HubertD/candleLight/export/v1.1/png/back.jpg

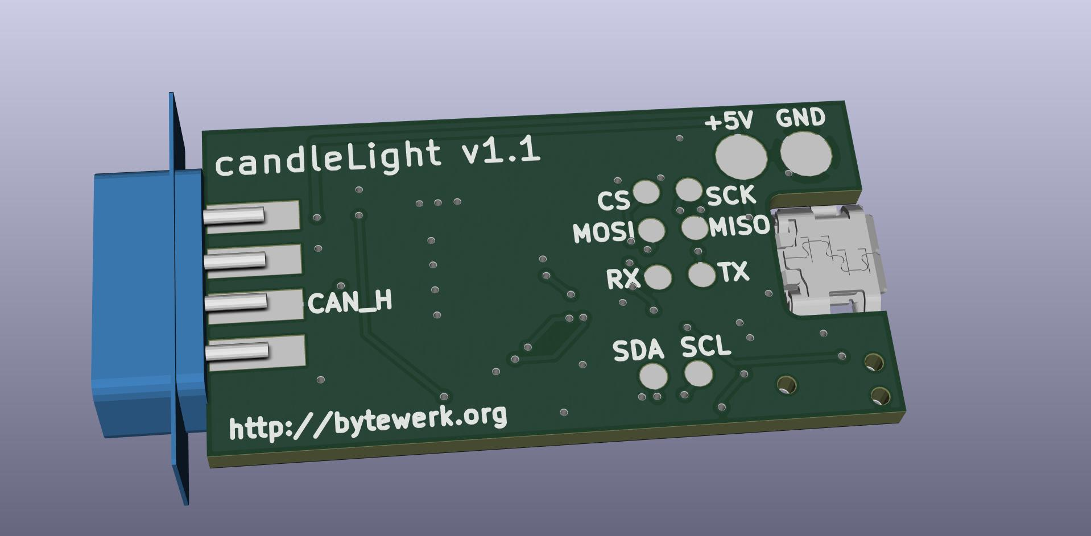
export/v1.1/png/back.jpg
