HubertD/candleLight/export/v1.1/png/front.jpg

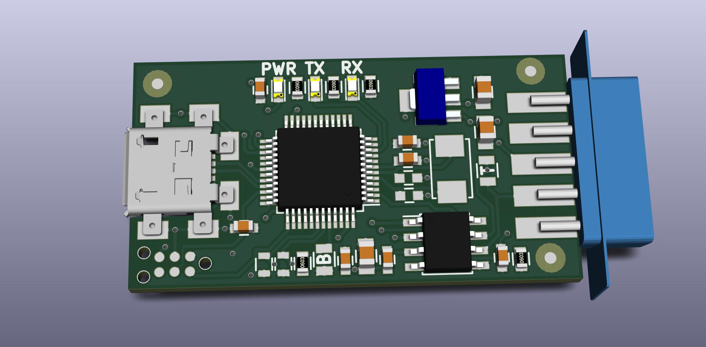
export/v1.1/png/front.jpg
