HubertD/candleLight/export/v1.1/bom/candleLight-v1.1.xls

Id | Designator | Package | Qty | Designation | Spec | Manufacturer | MPN | Link
1 | C207,C301,C303 | C_0805 | 3 | 10uF | MLCC/10uF/10V | Murata | GRM21BR71A106KA73L | http://www.mouser.de/Search/ProductDetail.aspx?R=GRM21BR71A106KA73L
2 | C206,C403,C203,C204,C205,C402,C208 | C_0603 | 7 | 100nF | MLCC/0.1uF/10V | AVX | 0603YC104KAT2A | http://www.mouser.de/Search/ProductDetail.aspx?R=0603YC104KAT2A
3 | R204,R601,R602,R603 | R_0603 | 4 | 1K | 1K/5% | Yageo | RC0603FR-071KL | http://www.mouser.de/Search/ProductDetail.aspx?R=RC0603FR-071KL
4 | R401 | R_0603 | 1 | 10K | 10K/5% | Yageo | RC0603FR-0710KL | http://www.mouser.de/Search/ProductDetail.aspx?R=RC0603FR-0710KL
5 | D601 | LED_0603 | 1 | LED | green,any | Kingbright | APT1608SGC | http://www.mouser.de/Search/ProductDetail.aspx?R=APT1608SGC
6 | D602 | LED_0603 | 1 | LED | yellow, any | Kingbright | APT1608YC | http://www.mouser.de/Search/ProductDetail.aspx?R=APT1608YC
7 | D603 | LED_0603 | 1 | LED | red, any | Kingbright | APT1608EC | http://www.mouser.de/Search/ProductDetail.aspx?R=APT1608EC
8 | U301 | SOT89-3 | 1 | MCP1754ST-3302E/MB | exact | Microchip | MCP1754ST-3302E/MB | http://www.mouser.de/Search/ProductDetail.aspx?R=MCP1754ST-3302E%2fMB
9 | U401 | SOIC-8_3.9x4.9mm_Pitch1.27mm | 1 | TJA1051/3 | exact | NXP | TJA1051T/3/1J | http://www.mouser.de/Search/ProductDetail.aspx?R=TJA1051T%2f3%2f1J
10 | U201 | LQFP-48_7x7mm_Pitch0.5mm | 1 | STM32F072C8Tx | exact | STMicroelectronics | STM32F072C8T6 | http://www.mouser.de/Search/ProductDetail.aspx?R=STM32F072C8T6
11 | P501 | Molex 47491-0001 | 1 | USB_OTG | exact | Molex | 47491-0001 | http://www.mouser.de/Search/ProductDetail.aspx?R=47491-0001
12 | X502 | DB9M_CI | 1 | SUB-D9 | hand solder | Kobiconn | 156-1209T-E | http://www.mouser.de/Search/ProductDetail.aspx?R=156-1209T-E
