HubertD/candleLight/export/v1.1/pdf/placement.pdf

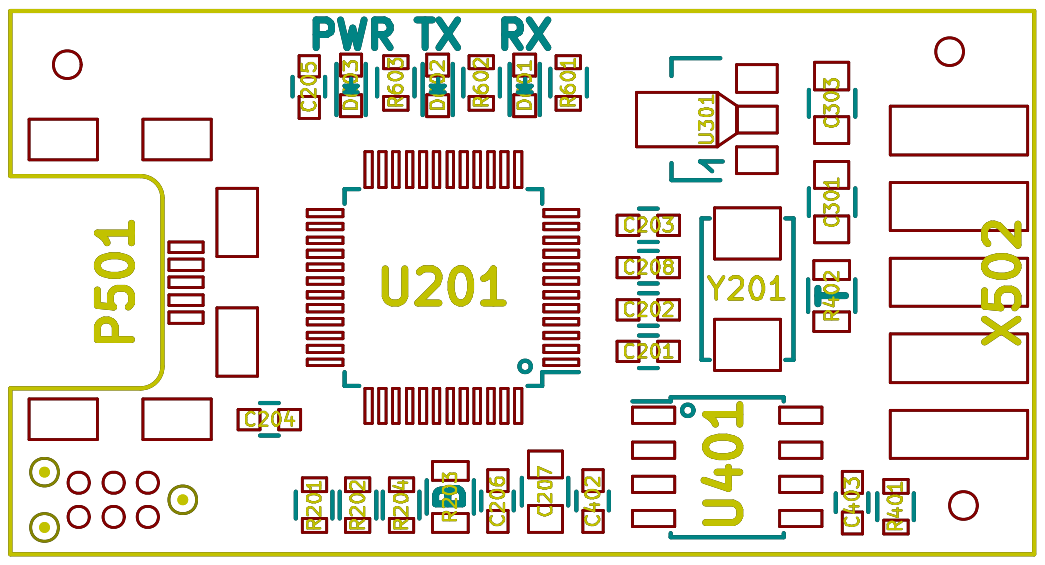
[picture p3: page 1]
