HubertD/candleLight/candleLight.kicad_pcb

## KiCad design candleLight.kicad_pcb (2016-05-12)

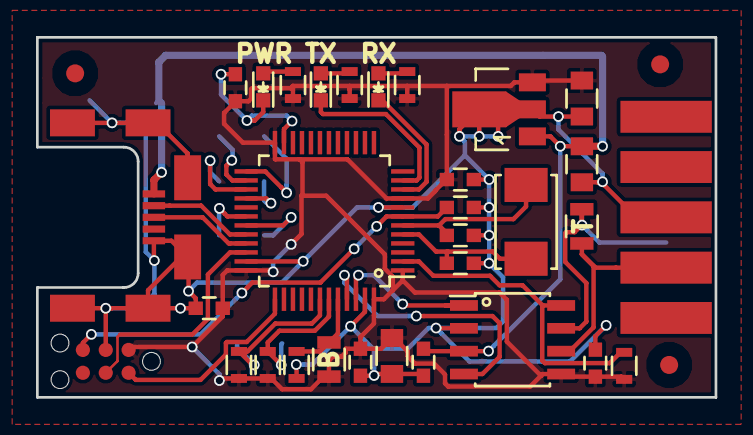
[picture p10: board candleLight.kicad_pcb from above]

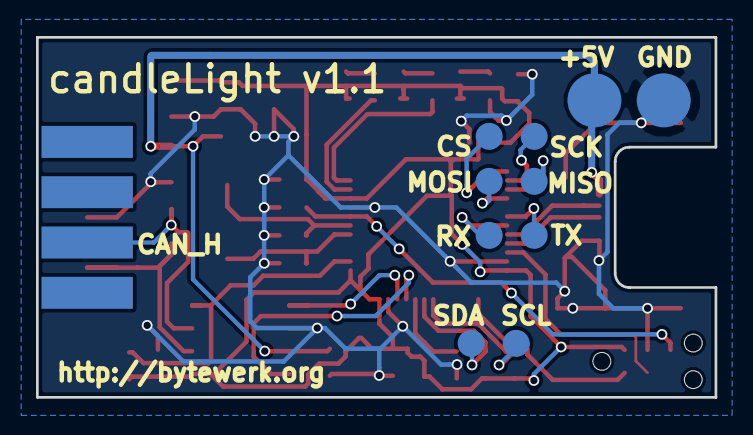
[picture p11: board candleLight.kicad_pcb from below]

Board: 2 copper layers, 37.7 x 20.0 mm, 44 parts (10 on the bottom side), 29 nets.

Parts:
C201, C202: 20pF; C_0603
C203, C204, C205, C206, C208, C402, C403: 100nF; C_0603
C207, C301, C303: 10uF; C_0805
CS: TEST_1P; Measurement_Point_Round-SMD-Pad_Small
D601, D602, D603: LED; LED_0603
FID101, FID102, FID103: Dummy_FIDUCIAL_Passermarke_Type1_RevE_Date16Nov20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; Fiducial_1mm_Dia_2.54mm_Outer_CopperTop
MISO: TEST_1P; Measurement_Point_Round-SMD-Pad_Small
MOSI: TEST_1P; Measurement_Point_Round-SMD-Pad_Small
P501: USB_OTG; Molex-Micro-USB-B-Middle-Mount
R201, R202: 4K7; R_0603
R203: R; R_0805
R204, R601, R602, R603: 1K; R_0603
R401: 10K; R_0603
R402: dnp; R_0805
RX: TEST_1P; Measurement_Point_Round-SMD-Pad_Small
SCK: TEST_1P; Measurement_Point_Round-SMD-Pad_Small
SCL: TEST_1P; Measurement_Point_Round-SMD-Pad_Small
SDA: TEST_1P; Measurement_Point_Round-SMD-Pad_Small
TX: TEST_1P; Measurement_Point_Round-SMD-Pad_Small
U201: STM32F072C8Tx; LQFP-48_7x7mm_Pitch0.5mm
U301: MCP1754ST-3302E/MB; SOT89-3_Housing
U401: TJA1051/3; SOIC-8_3.9x4.9mm_Pitch1.27mm
W301, W302: TEST_1P; Measurement_Point_Round-SMD-Pad_Big
X501: CON_SWD; TC2030-NL
X502: SUB-D9; DB9M_CI
Y201: 8MHz; ABM3

Connections:
+3V3: C203.1, C204.1, C205.1, C206.1, C207.1, C303.1, C403.1, R201.1, R202.2, R203.1, R401.1, R601.2, R602.2, R603.2, U201.1, U201.9, U201.24, U201.36, U201.48, U301.3, U401.5, X501.1
+5V: C301.1, C402.1, P501.1, U301.1, U401.3, W301.1
/CAN/CAN_H: R402.1, U401.7, X502.7
/CAN/CAN_L: R402.2, U401.6, X502.2
/CAN/CAN_S: R401.2, U201.2, U401.8
/Connectors/NRST: C208.1, U201.7, X501.5
/Connectors/SWCLK: U201.37, X501.2
/Connectors/SWDIO: U201.34, X501.4
/Connectors/USB_DM: P501.2, U201.32
/Connectors/USB_DP: P501.3, U201.33
/LEDs/LED1: D601.1, U201.10
/LEDs/LED2: D602.1, U201.11
/MCU/BOOT0: R203.2, R204.2, U201.44
/MCU/CAN_RX: U201.45, U401.4
/MCU/CAN_TX: U201.46, U401.1
GND: C201.1, C202.1, C203.2, C204.2, C205.2, C206.2, C207.2, C208.2, C301.2, C303.2, C402.2, C403.2, D603.1, P501.5, P501.6, R204.1, U201.8, U201.23, U201.35, U201.47, U301.2, U401.2, W302.1, X501.3, X502.3
unnamed: C201.2, U201.5, Y201.1
unnamed: C202.2, U201.6, Y201.2
unnamed: D601.2, R601.1
unnamed: D602.2, R602.1
unnamed: D603.2, R603.1
unnamed: R201.2, SCL.1, U201.42
unnamed: R202.1, SDA.1, U201.43
unnamed: CS.1, U201.25
unnamed: SCK.1, U201.26
unnamed: MISO.1, U201.27
unnamed: MOSI.1, U201.28
unnamed: TX.1, U201.30
unnamed: RX.1, U201.31
