HubertD/candleLight/(threads)

Thread 1 (2018-02-05):

Flashed both bin into a canable clone

riodda, 2018-02-05:
Hi i've made a canable clone and i've tryed to flash both the binaries avilable but i have no usb device showing up nor any led activity, i guess that the problem is that canable has StM32F04 with internal oscillator, while candlelight board has F07 internal oscillator and cantact has F04 external oscillator, i guess in the makefile there is the need of a new board definition ? Sorry i'm not very much into making firmwares.
Thanks.

Thread 2 (2021-06-02):

Can't program the board

Degg98, 2021-06-02:
Hi, I made four board for a formula student driverless car project, but actually can't program them. I'm using an st-link v2/1, the boot0 pin is pulled up (3v3) and the NRST is not grounded. I've done some changes like add a Usb C connector instead the micro-usb connector. If you can help me, it would be appreciate. (I can share my kicad project)
Thanks in advance.

Closed 2021-06-03.
