HubertD/candleLight/(commit log)

2016-03-26 first checkin
    [CAN.sch, candleLight.kicad_pcb, candleLight.sch, con.sch, leds.sch, mcu.sch, power.sch]
2016-03-28 set subd9 pin 3 to gnd, correct solder mask margin
    [candleLight.kicad_pcb, con.sch]
2016-03-29 rename con.sch to connectors.sch (allow checkout in windows)
    [candleLight.sch, connectors.sch]
2016-03-29 add missing usb data line resistors
    [CAN.sch, candleLight.kicad_pcb, connectors.sch, leds.sch, mcu.sch, power.sch]
2016-03-30 add fiducials
    [CAN.sch, candleLight.kicad_pcb, candleLight.sch, connectors.sch, leds.sch, mcu.sch, power.sch]
2016-03-30 adjust +3v3 plane settings
    [candleLight.kicad_pcb]
2016-04-28 remove unneeded parts
    [CAN.sch, mcu.sch]
2016-04-28 add testpoints, reset line cap
    [CAN.sch, candleLight.sch, connectors.sch, leds.sch, mcu.sch, power.sch]
2016-04-28 candleLight v1.2
    [candleLight.kicad_pcb, mcu.sch, power.sch]
2016-04-28 new measurements
    [candleLight.kicad_pcb]
2016-04-29 fine tuning
    [candleLight.kicad_pcb]
2016-04-29 create BOM
    [candleLight-v1.1.xls]
2016-04-29 add export files for v1.1
    [candleLight_v1.1_4x6-B.Cu.gbl, candleLight_v1.1_4x6-B.Mask.gbs, candleLight_v1.1_4x6-B.SilkS.gbo, candleLight_v1.1_4x6-Edge.Cuts.gm1, candleLight_v1.1_4x6-F.Cu.gtl, candleLight_v1.1_4x6-F.Mask.gts, candleLight_v1.1_4x6-F.Paste.gtp, candleLight_v1.1_4x6-F.SilkS.gto]
2016-05-12 move gerber panel files to own dir
    [candleLight_v1.1_4x6-B.Cu.gbl, candleLight_v1.1_4x6-B.Mask.gbs, candleLight_v1.1_4x6-B.SilkS.gbo, candleLight_v1.1_4x6-Edge.Cuts.gm1, candleLight_v1.1_4x6-F.Cu.gtl, candleLight_v1.1_4x6-F.Mask.gts, candleLight_v1.1_4x6-F.Paste.gtp, candleLight_v1.1_4x6-F.SilkS.gto]
2016-05-12 change placement texts
    [candleLight.kicad_pcb]
2016-05-12 add panel pcb
2016-05-12 add single board pick&place file
